voluta-coop/Open-KIoT/HW/Imágenes/photo_2022-05-06_11-35-10.jpg

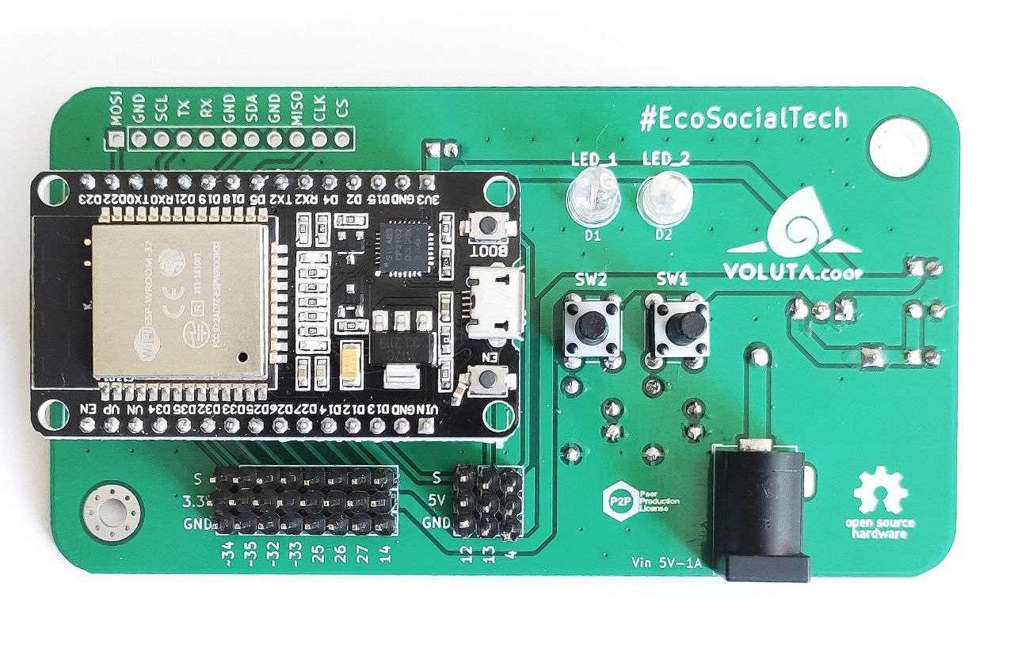
HW/Imágenes/photo_2022-05-06_11-35-10.jpg
