voluta-coop/Open-KIoT/HW/Imágenes/photo_2022-05-06_11-34-59.jpg

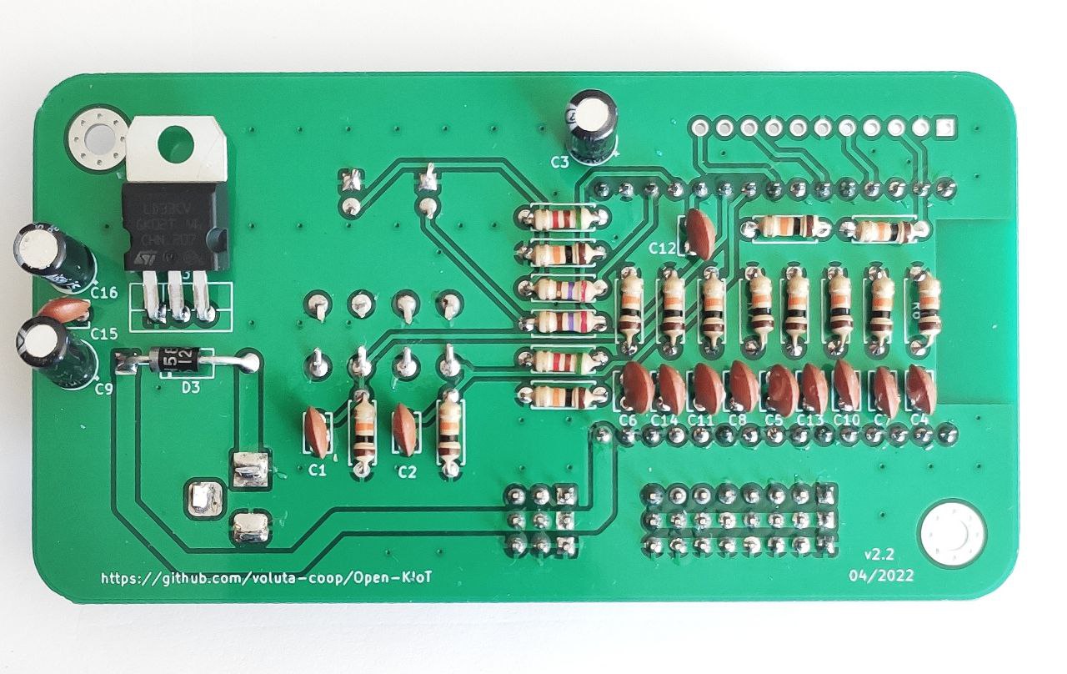
HW/Imágenes/photo_2022-05-06_11-34-59.jpg
