voluta-coop/Open-KIoT/HW/PCB/KiCad/Open_KIoT.step

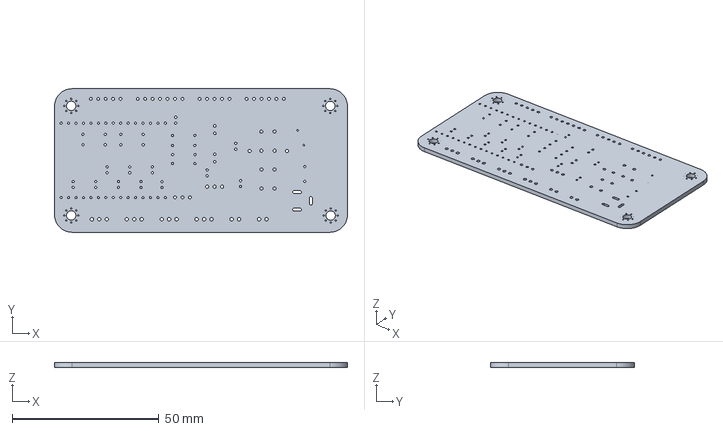
[picture p4: CAD file, 2022-04-28]
HW/PCB/KiCad/Open_KIoT.step
100.0 x 49.0 x 1.60 mm
