voluta-coop/Open-KIoT/HW/PCB/KiCad/edge_2.dxf

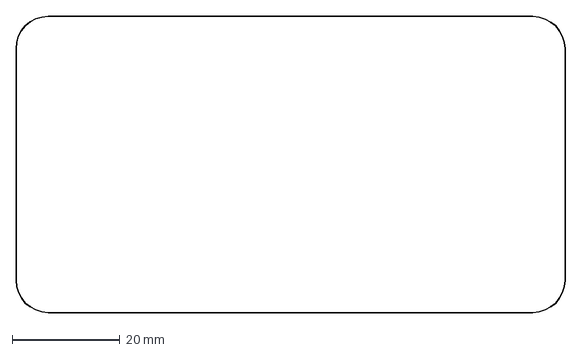
[picture p5: CAD file, 2022-04-28]
HW/PCB/KiCad/edge_2.dxf
102.0 x 55.0 mm
