voluta-coop/Open-KIoT/HW/PCB/Esquema/Esquema.pdf

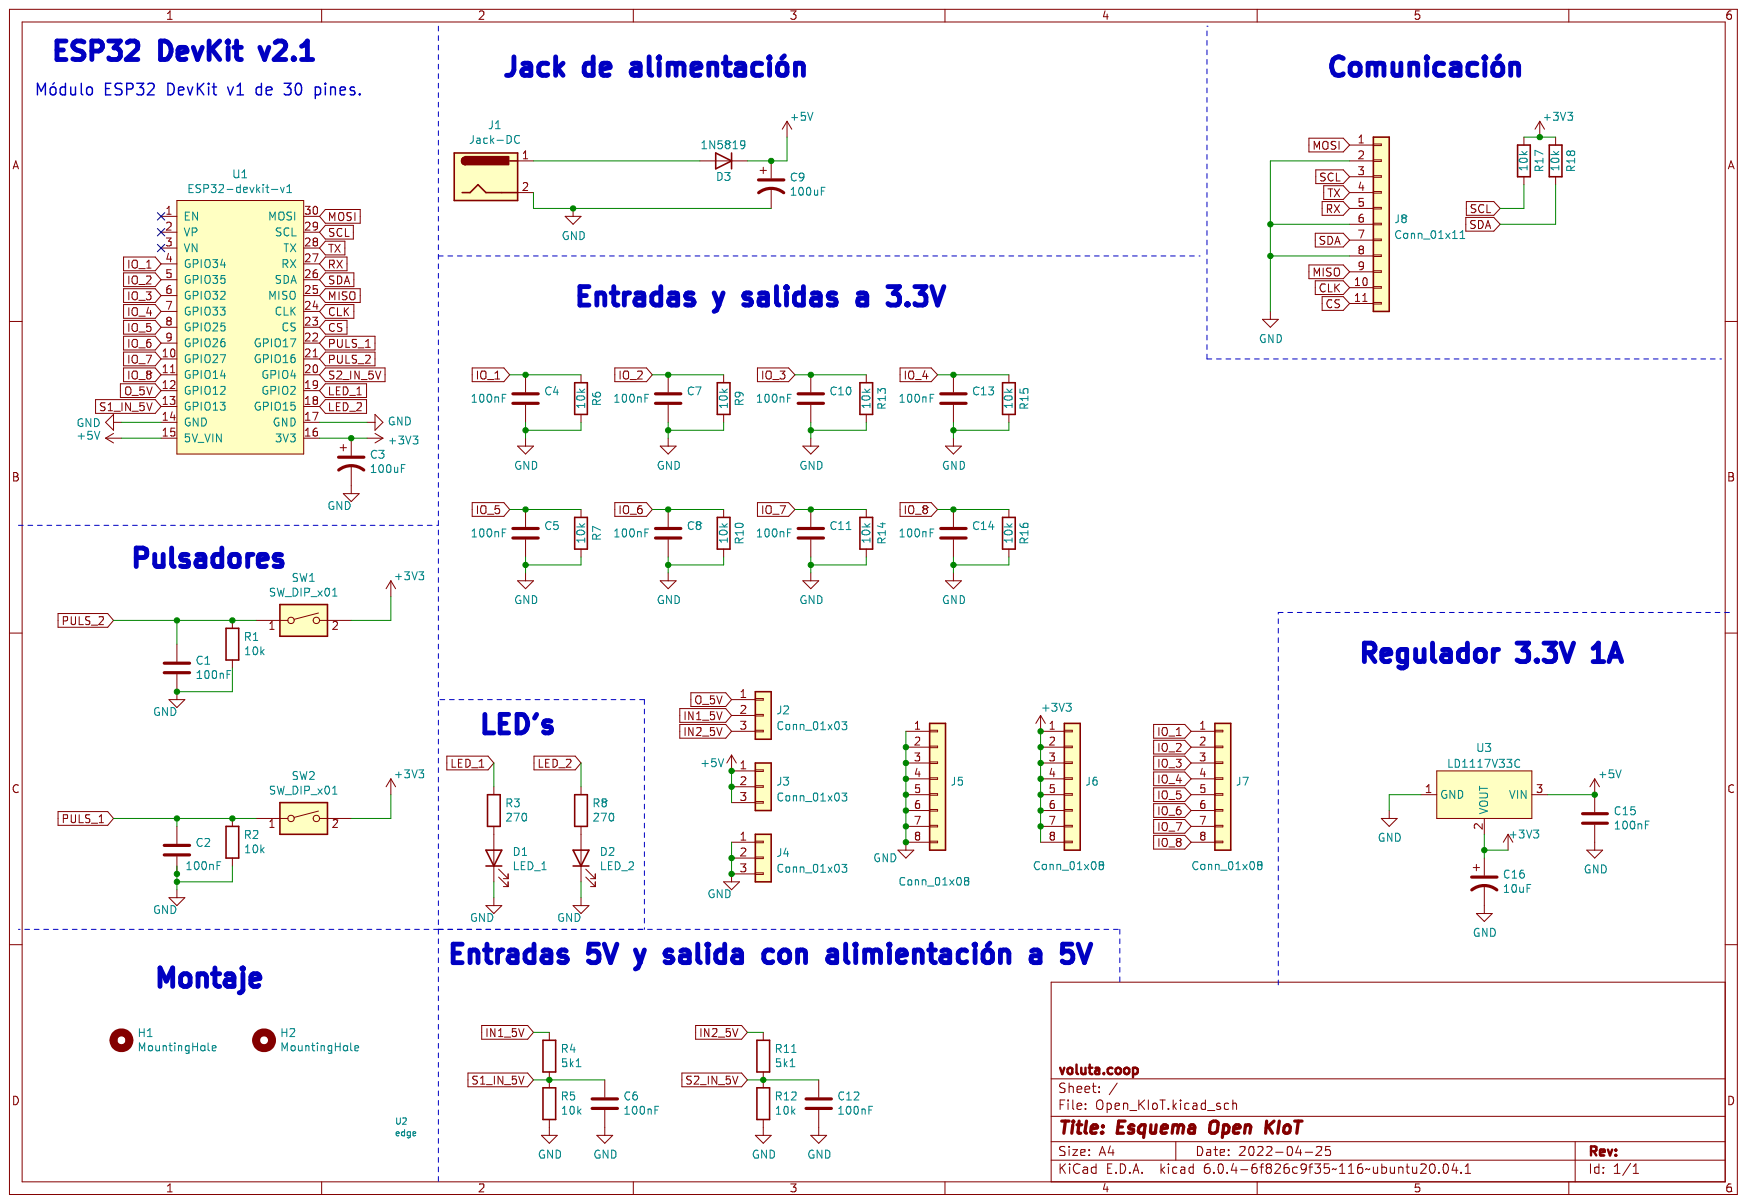
[picture p6: page 1]
