voluta-coop/Open-KIoT/HW/PCB/KiCad/Open_KIoT.kicad_pcb

## KiCad design HW/PCB/KiCad/Open_KIoT.kicad_pcb (2022-04-28)

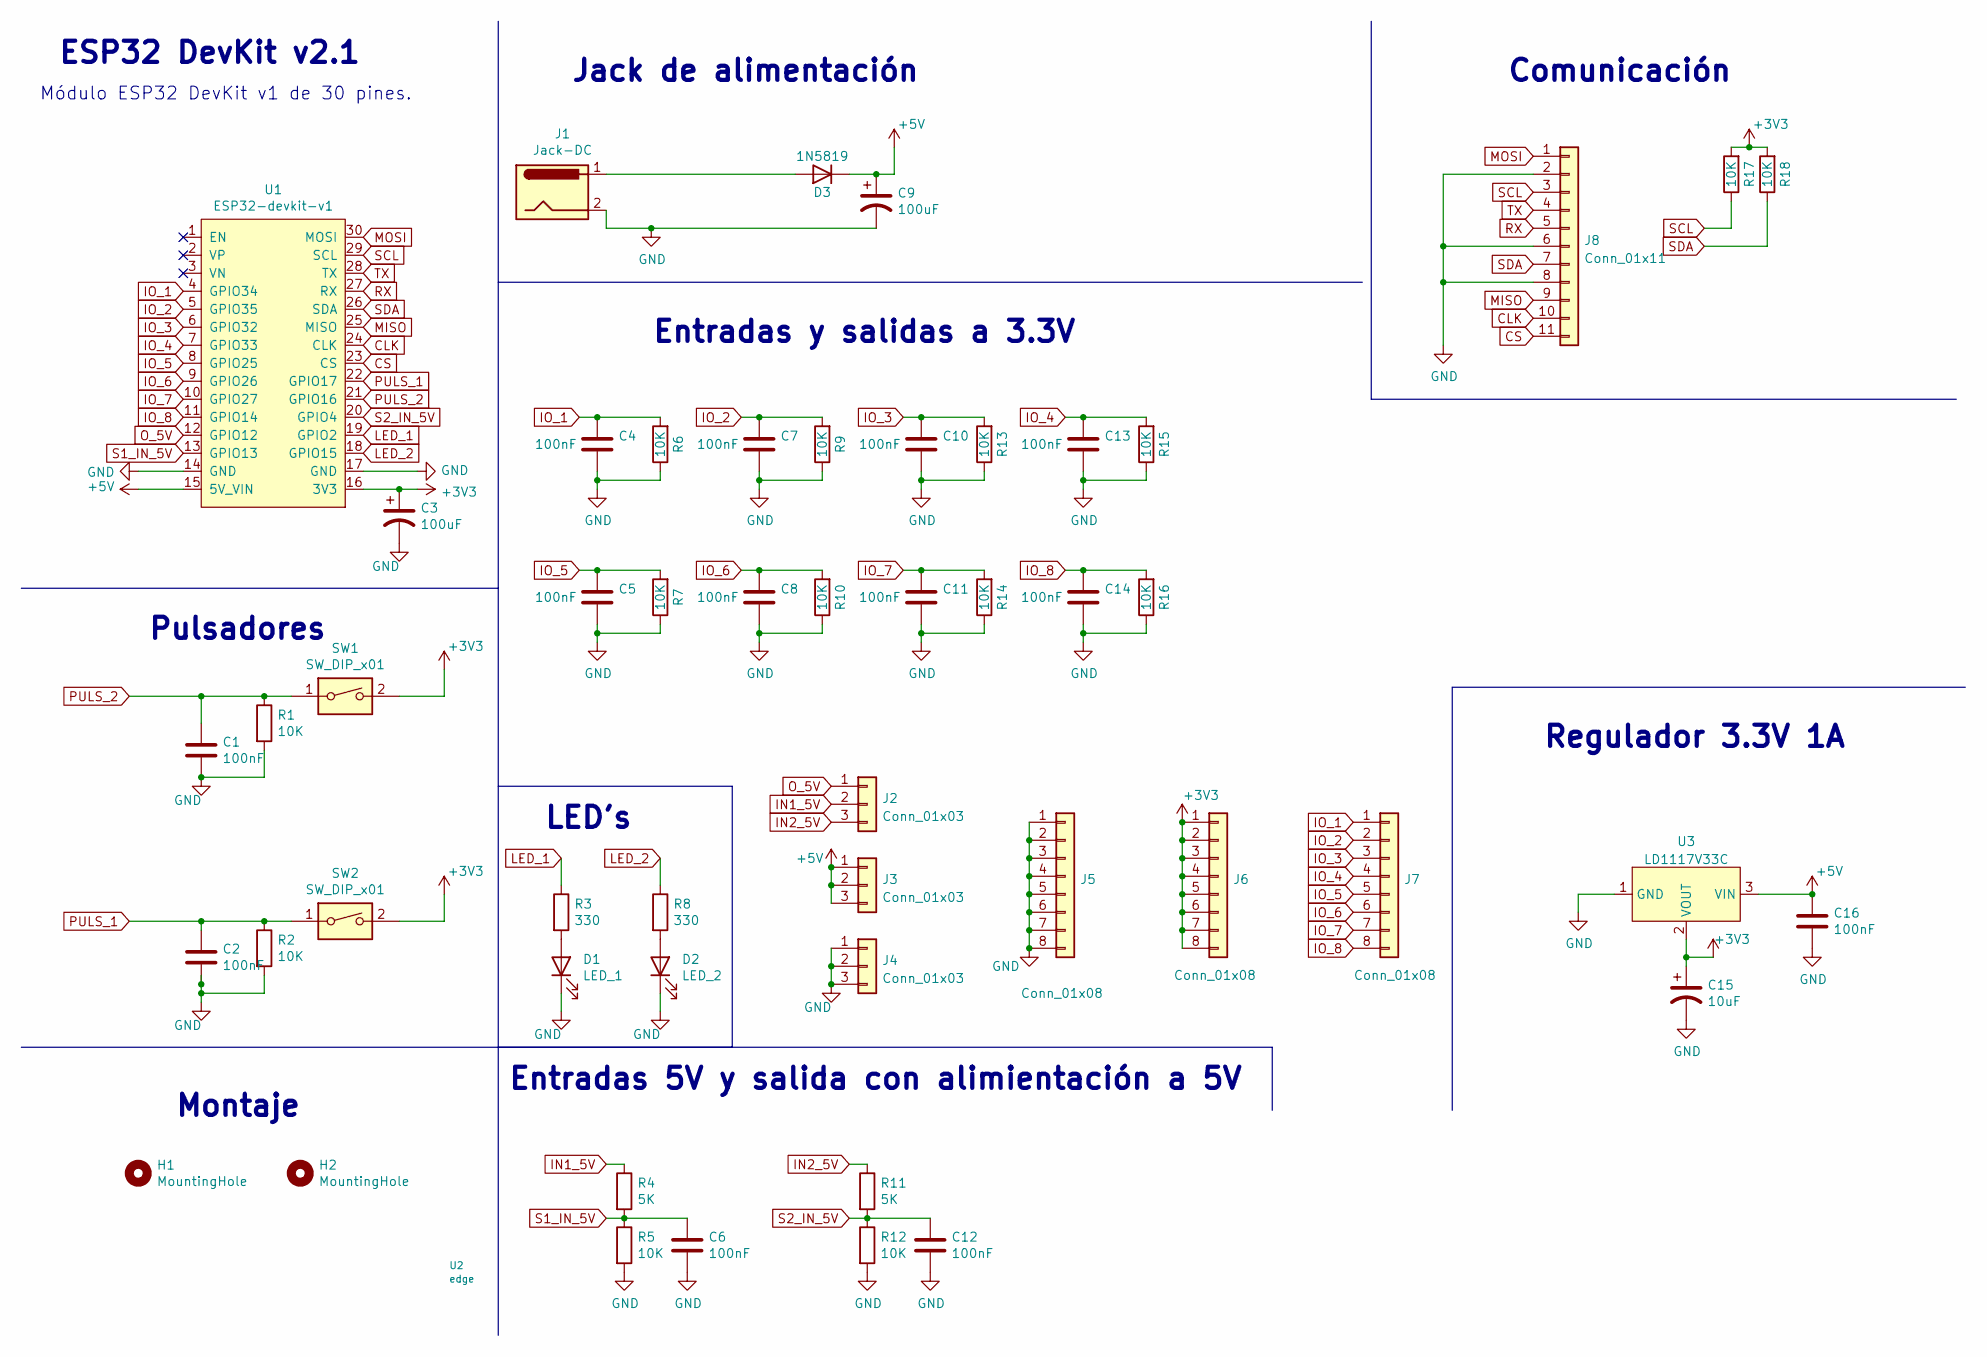
[picture p7: schematic Open_KIoT.kicad_sch, Esquema Open KIoT]

Parts:
C1, C2, C4, C5, C6, C7, C8, C10, C11, C12, C13, C14, C16: 100nF; C_Disc_D3.8mm_W2.6mm_P2.50mm
C3, C9: 100uF; CP_Radial_D5.0mm_P2.00mm
C15: 10uF; CP_Radial_D5.0mm_P2.00mm
D1: LED_1; LED_D5.0mm_Clear
D2: LED_2; LED_D5.0mm_Clear
D3: 1N5819; D_DO-41_SOD81_P12.70mm_Horizontal
H1, H2: MountingHole; MountingHole_3.2mm_M3_Pad_Via
J1: Jack-DC; BarrelJack_Horizontal
J2, J3, J4: Conn_01x03; PinHeader_1x03_P2.54mm_Vertical
J5, J6, J7: Conn_01x08; PinHeader_1x08_P2.54mm_Vertical
J8: Conn_01x11; PinHeader_1x11_P2.54mm_Vertical
R1, R2, R5, R6, R7, R9, R10, R12, R13, R14, R15, R16, R17, R18: 10K; R_Axial_DIN0207_L6.3mm_D2.5mm_P7.62mm_Horizontal
R3, R8: 330; R_Axial_DIN0207_L6.3mm_D2.5mm_P7.62mm_Horizontal
R4, R11: 5K; R_Axial_DIN0207_L6.3mm_D2.5mm_P7.62mm_Horizontal
SW1, SW2: SW_DIP_x01; SW_PUSH_6mm_H4.3mm
U1: ESP32-devkit-v1; ESP32-DevKit-v1
U2: edge; edge_2
U3: LD1117V33C; TO-220F-3_Vertical

Connections:
+3V3: C3.1, C15.1, J6.1, J6.2, J6.3, J6.4, J6.5, J6.6, J6.7, J6.8, R17.2, R18.2, SW1.2, SW2.2, U1.16 (3V3), U3.2 (VOUT)
+5V: C9.1, C16.1, D3.1 (K), J3.1, J3.2, J3.3, U1.15 (5V_VIN), U3.3 (VIN)
CLK: J8.10, U1.24 (CLK)
CS: J8.11, U1.23 (CS)
GND: C1.2, C2.2, C3.2, C4.2, C5.2, C6.2, C7.2, C8.2, C9.2, C10.2, C11.2, C12.2, C13.2, C14.2, C15.2, C16.2, D1.1 (K), D2.1 (K), J1.2, J4.1, J4.2, J4.3, J5.1, J5.2, J5.3, J5.4, J5.5, J5.6, J5.7, J5.8, J8.2, J8.6, J8.8, R1.2, R2.2, R5.2, R6.1, R7.1, R9.1, R10.1, R12.2, R13.1, R14.1, R15.1, R16.1, U1.14 (GND), U1.17 (GND), U3.1 (GND)
IN1_5V: J2.2, R4.1
IN2_5V: J2.3, R11.1
IO_1: C4.1, J7.1, R6.2, U1.4 (GPIO34)
IO_2: C7.1, J7.2, R9.2, U1.5 (GPIO35)
IO_3: C10.1, J7.3, R13.2, U1.6 (GPIO32)
IO_4: C13.1, J7.4, R15.2, U1.7 (GPIO33)
IO_5: C5.1, J7.5, R7.2, U1.8 (GPIO25)
IO_6: C8.1, J7.6, R10.2, U1.9 (GPIO26)
IO_7: C11.1, J7.7, R14.2, U1.10 (GPIO27)
IO_8: C14.1, J7.8, R16.2, U1.11 (GPIO14)
LED_1: R3.1, U1.19 (GPIO2)
LED_2: R8.1, U1.18 (GPIO15)
MISO: J8.9, U1.25 (MISO)
MOSI: J8.1, U1.30 (MOSI)
unnamed: D1.2 (A), R3.2
unnamed: D2.2 (A), R8.2
unnamed: D3.2 (A), J1.1
O_5V: J2.1, U1.12 (GPIO12)
PULS_1: C2.1, R2.1, SW2.1, U1.22 (GPIO17)
PULS_2: C1.1, R1.1, SW1.1, U1.21 (GPIO16)
RX: J8.5, U1.27 (RX)
S1_IN_5V: C6.1, R4.2, R5.1, U1.13 (GPIO13)
S2_IN_5V: C12.1, R11.2, R12.1, U1.20 (GPIO4)
SCL: J8.3, R17.1, U1.29 (SCL)
SDA: J8.7, R18.1, U1.26 (SDA)
TX: J8.4, U1.28 (TX)

Notes on the sheet:
Regulador 3.3V 1A
Módulo ESP32 DevKit v1 de 30 pines.
Entradas 5V y salida con alimientación a 5V
Pulsadores
Entradas y salidas a 3.3V
Comunicación
Montaje
ESP32 DevKit v2.1
LED's
Jack de alimentación

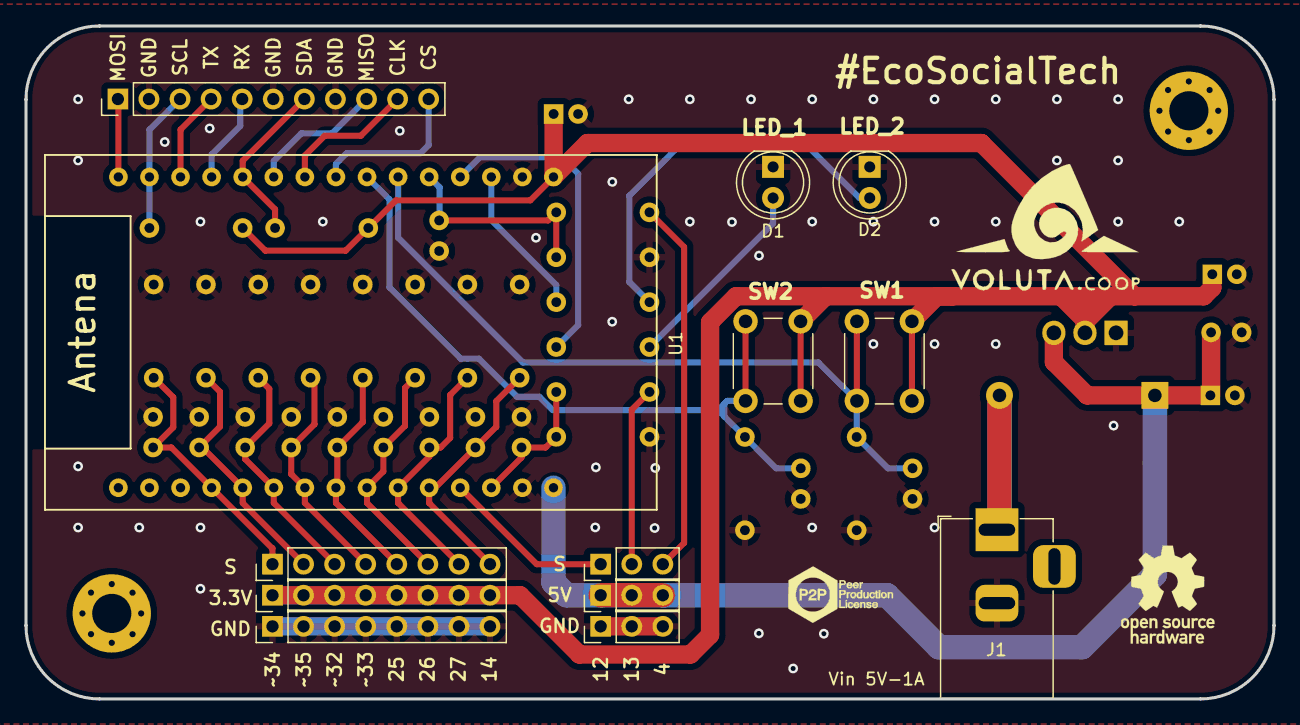
[picture p8: board Open_KIoT.kicad_pcb from above]

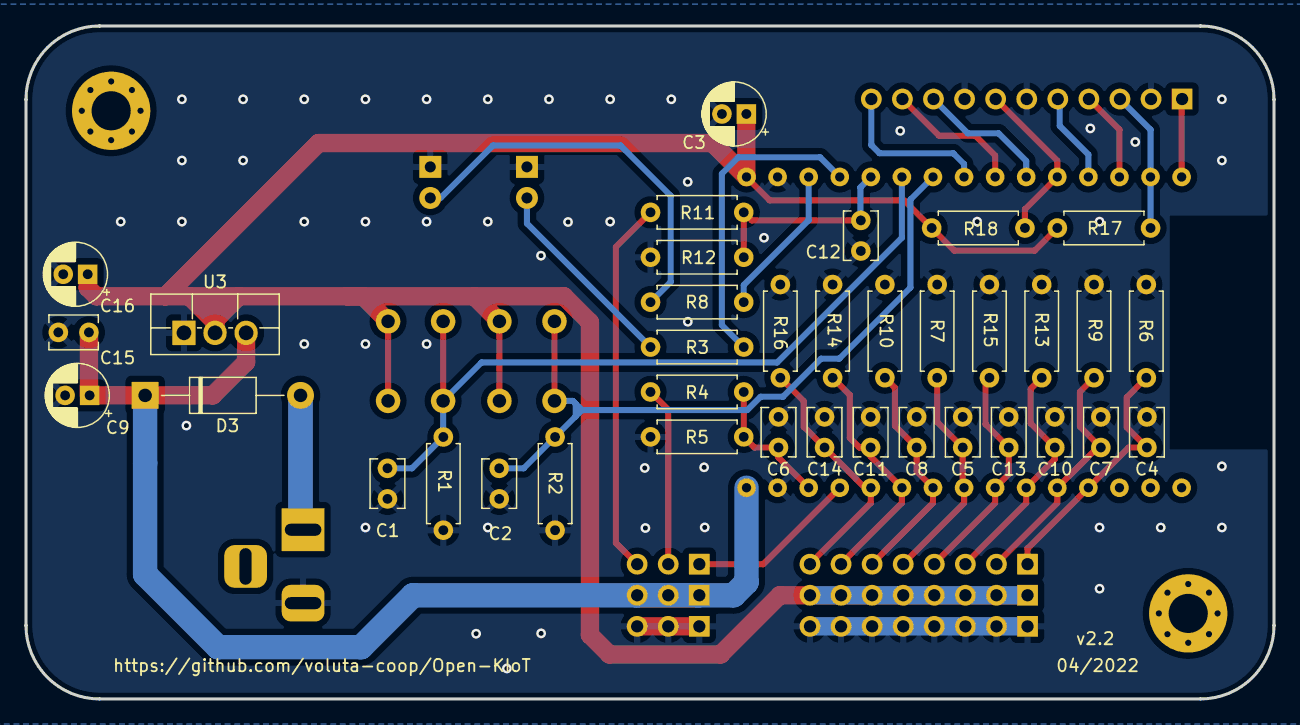
[picture p9: board Open_KIoT.kicad_pcb from below]

Board: 2 copper layers, 102.0 x 55.0 mm, 51 parts (36 on the bottom side), 31 nets.
