voluta-coop/Open-KIoT/(commit log)

2022-04-28 Inicio el repositorio de Open KIoT
    [Open_KIoT-B_Cu.gbl, Open_KIoT-B_Mask.gbs, Open_KIoT-B_Paste.gbp, Open_KIoT-B_SilkS.gbo, Open_KIoT-B_Silkscreen.gbo, Open_KIoT-Edge_Cuts.gm1, Open_KIoT-F_Cu.gtl, Open_KIoT-F_Mask.gts]
2022-04-29 Añadido el test del sensor DHT11 con bot de Telegram
2022-04-29 Reestructuración de carpetas
    [Open_KIoT-B_Cu.gbl, Open_KIoT-B_Mask.gbs, Open_KIoT-B_Paste.gbp, Open_KIoT-B_SilkS.gbo, Open_KIoT-B_Silkscreen.gbo, Open_KIoT-Edge_Cuts.gm1, Open_KIoT-F_Cu.gtl, Open_KIoT-F_Mask.gts]
2022-05-02 Icluido el esquema de la PCB en PDF
    [Open_KIoT-B_Cu.gbl, Open_KIoT-B_Mask.gbs, Open_KIoT-B_Paste.gbp, Open_KIoT-B_SilkS.gbo, Open_KIoT-B_Silkscreen.gbo, Open_KIoT-Edge_Cuts.gm1, Open_KIoT-F_Cu.gtl, Open_KIoT-F_Mask.gts]
2022-05-02 Reestructuracion carpetas y esquema PCB en PDF añadido
    [Open_KIoT-B_Cu.gbl, Open_KIoT-B_Mask.gbs, Open_KIoT-B_Paste.gbp, Open_KIoT-B_SilkS.gbo, Open_KIoT-B_Silkscreen.gbo, Open_KIoT-Edge_Cuts.gm1, Open_KIoT-F_Cu.gtl, Open_KIoT-F_Mask.gts]
2022-05-02 Corrección errores valores resistencias
    [Open_KIoT.kicad_sch]
2022-05-03 Corrección error esquema
    [Open_KIoT.kicad_sch]
2022-05-06 Añadido doc con instrucciones de soldadura e imágenes de la PCB
